KiraFlux/Botix/docs/README.md

# Documentation

Technical documentation for the Botix robot project: assembly guide, part lists, 3D printing settings, electrical schematics, and visual assets.

## Directory Structure

| Path | Description |
| --- | --- |
| `assets/` | Images, renders, and photographs used in the documentation. |
| [`gallery.md`](gallery.md) | Visual gallery of robot iterations and hardware revisions. |
| [`printable_parts.md`](printable_parts.md) | List of printable parts |
| [`firmware_contributing.md`](firmware_contributing.md) | Detailed guidelines for firmware developers (code style, architecture, V‑codes). |
| [`assembly_guide.md`](assembly_guide.md) | Step‑by‑step assembly instructions with photos and diagrams.  *(not implemented yet)* |
| (future) | Electrical schematics, Bill of Materials (BOM), print profiles, and other technical references. |

## Usage

1. Start with [`assembly_guide.md`](assembly_guide.md) to build the robot.
2. Refer to `assets/` for visual references and illustrations.
3. Additional documentation (e.g., BOM, wiring diagrams) will be added here as the project evolves.

## Contributing

If you want to improve the documentation, please read the [general contributing guidelines](../CONTRIBUTING.md) and the [Documentation section](../CONTRIBUTING.md#documentation-docs) for specific rules.

## License

This README file and all other documentation in the `docs/` directory are licensed under **Creative Commons Attribution‑ShareAlike 4.0 International (CC BY‑SA 4.0)** – see the [full license text](LICENSE) for details.

For the complete licensing information of all project components, including hardware and firmware, refer to the [root repository README](../README.md#repository-structure--licensing).
