KiraFlux/Botix/docs/gallery.md

# Botix project gallery

This gallery provides a curated visual overview of the Botix mobile robot project. It collects systematic photographs from the development process (originally published in the project's Telegram channel) and organizes them for quick reference. The images document the evolution of the robot, covering various hardware iterations, chassis assemblies, power electronics, sensor configurations, and controller boards. The gallery will be updated as new revisions and components are introduced.

---

## botix_esp32_2026_07

<table cellspacing="0" cellpadding="0" style="border-collapse: collapse;">
<tr nowrap>
  <td style="padding: 0;"></td>
  <td style="padding: 0;"></td>
  <td style="padding: 0;"></td>
  <td style="padding: 0;"></td>
</tr>
<tr nowrap>
  <td style="padding: 0;"></td>
  <td style="padding: 0;"></td>
  <td style="padding: 0;"></td>
  <td style="padding: 0;"></td>
</tr>
<tr nowrap>
</tr>
  <td style="padding: 0;"></td>
  <td style="padding: 0;"></td>
</table>

ESP32 version on updated chassis. Uses the double‑sided power board (toner transfer method), which was tested on this robot.

---

## botix_uno_2026_07

<table cellspacing="0" cellpadding="0" style="border-collapse: collapse;">
<tr nowrap>
  <td style="padding: 0;"></td>
  <td style="padding: 0;"></td>
  <td style="padding: 0;"></td>
  <td style="padding: 0;"></td>
</tr>
<tr nowrap>
  <td style="padding: 0;"></td>
  <td style="padding: 0;"></td>
  <td style="padding: 0;"></td>
  <td style="padding: 0;"></td>
</tr>
</table>

Current basic-robot version. Chassis with low frames and side walls. Color scheme changed to light colors: white platform and deck, orange walls, frames and sensor mounts. Hardware composition remains the same.

---

## botix_power_v2_ttm_double_2026_07

<table cellspacing="0" cellpadding="0" style="border-collapse: collapse;">
<tr nowrap>
  <td style="padding: 0;"></td>
  <td style="padding: 0;"></td>
  <td style="padding: 0;"></td>
</tr>
<tr nowrap>
  <td style="padding: 0;"></td>
  <td style="padding: 0;"></td>
  <td style="padding: 0;"></td>
  <td style="padding: 0;"></td>
  <td style="padding: 0;"></td>
  <td style="padding: 0;"></td>
</tr>
<tr nowrap>
  <td style="padding: 0;"></td>
  <td style="padding: 0;"></td>
  <td style="padding: 0;"></td>
  <td style="padding: 0;"></td>
  <td style="padding: 0;"></td>
  <td style="padding: 0;"></td>
</tr>
</table>

Double‑layer power board, manufactured using the toner transfer method (TTM).

---

## botix_power_v2_ttm_single_2026_07

<table cellspacing="0" cellpadding="0" style="border-collapse: collapse;">
<tr nowrap>
  <td style="padding: 0;"></td>
  <td style="padding: 0;"></td>
  <td style="padding: 0;"></td>

  <td style="padding: 0;"></td>
</tr>
<tr nowrap>
  <td style="padding: 0;"></td>
  <td style="padding: 0;"></td>
  <td style="padding: 0;"></td>
  <td style="padding: 0;"></td>
</tr>
</table>

Single‑sided version of the same board, also made with toner transfer.

---

## botix_power_v2_pcb_order_2026_07

<table cellspacing="0" cellpadding="0" style="border-collapse: collapse;">
<tr nowrap>
  <td style="padding: 0;"></td>
  <td style="padding: 0;"></td>
  <td style="padding: 0;"></td>
  <td style="padding: 0;"></td>
</tr>
<tr nowrap>
  <td style="padding: 0;"></td>
  <td style="padding: 0;"></td>
  <td style="padding: 0;"></td>
  <td style="padding: 0;"></td>
</tr>
</table>

## botix_power_v2_pcb_order_2026_07

New revision of the power board. After a year of use, limitations of the first version became apparent: lack of terminals, and problems with back‑EMF from servos (a large servo would "kill" a smaller one with its inductance).
Solutions: two independent channels on Mini560 PRO (5V) with 35V 470 µF capacitors on each line; terminals for direct battery voltage output (used to power motor drivers); parallel input before the switch (allows connecting an external source instead of the 3S pack); six mounting holes (3 left, 3 right); outputs now available both via terminals and Dupont headers (for servo connections).

> The version shown in the photos had a routing error - a missing trace between the two holder pads, so a red jumper wire was added on the back side. This has been fixed in the current revision available in the repository.

---

## botix_esp32_2026_05

<table cellspacing="0" cellpadding="0" style="border-collapse: collapse;">
<tr nowrap>
  <td style="padding: 0;"></td>
  <td style="padding: 0;"></td>
</tr>
</table>

Alternative chassis design with low walls and frames — the robot became lower. No rear wall. Power board mounted flat on the platform. This is an ESP32 robot with a manipulator.

---

## botix_esp32_2026_03

<table cellspacing="0" cellpadding="0" style="border-collapse: collapse;">
<tr nowrap>
  <td style="padding: 0;"></td>
  <td style="padding: 0;"></td>
</tr>
</table>

Second iteration of the ESP32 robot. Uses the same module with a shield (ESP32D DevKit), but instead of a motor shield, separate DRV8871 motor drivers are used.

---

## botix_uno_2025_09

<table cellspacing="0" cellpadding="0" style="border-collapse: collapse;">
<tr nowrap>
  <td style="padding: 0;"></td>
  <td style="padding: 0;"></td>
  <td style="padding: 0;"></td>
</tr>
<tr nowrap>
</tr>
  <td style="padding: 0;"></td>
  <td style="padding: 0;"></td>
  <td style="padding: 0;"></td>
</table>

<table cellspacing="0" cellpadding="0" style="border-collapse: collapse;">
<tr nowrap>
  <td style="padding: 0;"></td>
  <td style="padding: 0;"></td>
</tr>
</table>

A direct evolution of the MOSH version with improved chassis and simplified assembly. Once the chassis was finalized and power boards manufactured, the school robotics team needed robots. Three units with manipulators were made. Manipulator changes: the 1109 servo was replaced by a more common MG90S, and the gear was modified. Module set: Arduino UNO + IArduino motor shield, IArduino module for line sensor, SHARP for distance sensing.

---

## botix_power_v1_2025_09

<table cellspacing="0" cellpadding="0" style="border-collapse: collapse;">
<tr nowrap>
  <td style="padding: 0;"></td>
  <td style="padding: 0;"></td>
  <td style="padding: 0;"></td>
</tr>
<tr nowrap>
  <td style="padding: 0;"></td>
  <td style="padding: 0;"></td>
</tr>
</table>

First version of the power board. Replaced the 18650 cells used in early prototypes with 14500 — more compact and safer for school use. Goal: simplify assembly and eliminate point‑to‑point wiring. Features: holder for 3S 14500 with direct access for quick replacement; switch breaking the negative line; two alternative footprints: either 2PH116602A or (on the reverse side) Mini560 PRO (5V) for isolated servo power; LM2596S with digital voltmeter for voltage monitoring (output set to 8V for the motor shield). This ensured stable motor speed as the battery discharged.

---

## botix_esp32_2025_08

<table cellspacing="0" cellpadding="0" style="border-collapse: collapse;">
<tr nowrap>
  <td style="padding: 0;"></td>
  <td style="padding: 0;"></td>
  <td style="padding: 0;"></td>
</tr>
</table>

Based on experience from VSOSH and MOSH, a new chassis was designed to be logical and not require future rework. Key decisions: strict 20 mm grid; unified tongue‑and‑groove pattern (also grid‑aligned); frames compatible with the manipulator from the TsPM (VSOSH). Uses: ball casters (as on the VSOSH robot), off‑the‑shelf RC wheels (D52 rim, 67 mm tyre). The rear wall does not contain a holder or converter — a full power board is installed (first iteration made with toner transfer, later production ordered). First attempt to use ESP32 as the main controller. Motor driver: IArduino UNO Motor Shield. Manipulator from TsPM: MG995 for the arm, 1109 for the gripper. Uses analogue sensors from Amperka (with potentiometer sensitivity adjustment) — same as used at VSOSH 2024/2025.

---

## historic_mosh_2024_11

<table cellspacing="0" cellpadding="0" style="border-collapse: collapse;">
<tr nowrap>
  <td style="padding: 0;"></td>
  <td style="padding: 0;"></td>
  <td style="padding: 0;"></td>
</tr>
<tr nowrap>
  <td style="padding: 0;"></td>
  <td style="padding: 0;"></td>
  <td style="padding: 0;"></td>
</tr>
</table>

Stage where successful features from the VSOSH chassis were adopted: open removable power board as a whole wall, deck above the motors for the controller. Introduced a 10‑mm grid with a successful slot pattern. Adapters were developed to mount VSOSH frames on the MOSH platform, allowing the manipulator to be used.

---

## historic_vsosh_2024_08

<table cellspacing="0" cellpadding="0" style="border-collapse: collapse;">
<tr nowrap>
  <td style="padding: 0;"></td>
  <td style="padding: 0;"></td>
  <td style="padding: 0;"></td>
</tr>
<tr nowrap>
  <td style="padding: 0;"></td>
  <td style="padding: 0;"></td>
  <td style="padding: 0;"></td>
</tr>
</table>

Chassis inspired by the robot shown by TsPM at the Moscow practical round. Originally designed for laser cutting from 4‑mm plywood, but 3D printing proved simpler and neater. Uses printed wheels and a plumbing‑grade rubber tyre (74 mm diameter) to simulate the slipping behavior of the original olympiad robot. Frames are compatible with the TsPM manipulator, but a first iteration of a custom manipulator with two MG90S servos was developed. Drawbacks: using MG90S for the arm linkage proved unsuccessful; gripper teeth too aggressive; scale about 1.5× larger than the olympiad robot.

---

## historic_mosh_2024_06

<table cellspacing="0" cellpadding="0" style="border-collapse: collapse;">
<tr nowrap>
  <td style="padding: 0;"></td>
  <td style="padding: 0;"></td>
  <td style="padding: 0;"></td>
</tr>
</table>

Switch to 3S (12V) power. Power module moved to the rear and made as a closed box with point‑to‑point wiring. Updated Arduino UNO adapter (added rear slots). Attempt to expand workspace with wheel covers. First experience with 3D‑printed wheel rims.

---

## historic_mosh_2024_01

<table cellspacing="0" cellpadding="0" style="border-collapse: collapse;">
<tr nowrap>
  <td style="padding: 0;"></td>
  <td style="padding: 0;"></td>
</tr>
<tr nowrap>
  <td style="padding: 0;"></td>
  <td style="padding: 0;"></td>
</tr>
</table>

Platform updated: more holes and bottom reinforcement ribs added.

---

## historic_mosh_2023_03

<table cellspacing="0" cellpadding="0" style="border-collapse: collapse;">
<tr nowrap>
  <td style="padding: 0;"></td>
  <td style="padding: 0;"></td>
  <td style="padding: 0;"></td>
</tr>
</table>

Earliest documented iteration. Powered by 2S 18650, stabilized with LM2596S and voltmeter. Arduino UNO mounted via an adapter to neutralize its irregular hole pattern. Used ball casters (inherited from the Amperka MiniQ). Round shape inspired by the MiniQ to simplify pivot turns.
