KiraFlux/Botix/docs/printable_parts.md

# Printable parts

## Chassis

<table cellspacing="0" cellpadding="0" style="border-collapse: collapse;">

<tr nowrap>
<td style="padding: 0;"></td>
<td style="padding: 0;"></td>
<td style="padding: 0;"></td>
<td style="padding: 0;"></td>
<td style="padding: 0;"></td>
<td style="padding: 0;"></td>
<td style="padding: 0;"></td>
</tr>

<tr nowrap>

<td align="center">
  
[platform](../mcad/export/platform.stp)

</td>

<td align="center">
  
[deck](../mcad/export/deck.stp)

</td>

<td align="center">
  
[nose_deck](../mcad/export/nose_deck.stp)

</td>

<td align="center">
  
[frame_small](../mcad/export/frame_small.stp)

</td>

<td align="center">
  
[side_wall_small](../mcad/export/side_wall_small.stp)

</td>

<td align="center">

[rear_wall](../mcad/export/rear_wall.stp)  

</td>

<td align="center">

[felt_support](../mcad/export/felt_support.stp)  

</td>

</tr>

</table>

## Mounts

<table cellspacing="0" cellpadding="0" style="border-collapse: collapse;">

<tr nowrap>
<td style="padding: 0;"></td>
<td style="padding: 0;"></td>
<td style="padding: 0;"></td>
</tr>

<tr nowrap>

<td align="center">
  
[sharp_mount](../mcad/export/sharp_mount.stp)

</td>

<td align="center">
  
[sharp_cover](../mcad/export/sharp_cover.stp)

</td>

<td align="center">
  
[hscr04_mount](../mcad/export/hscr04_mount.stp)

</td>

</tr>

</table>

## Fasteners

<table cellspacing="0" cellpadding="0" style="border-collapse: collapse;">

<tr nowrap>
<td style="padding: 0;"></td>
<td style="padding: 0;"></td>
</tr>

<tr nowrap>

<td align="center">
  
[bushing_m3](../mcad/export/bushing_m3.stp)

</td>

<td align="center">
  
[short_bushing_m3](../mcad/export/short_bushing_m3.stp)

</td>

</tr>

</table>
