KiraFlux/Botix/(list of files, cad)

Other CAD files:
mcad/botix.fcstd
mcad/export/felt_support.stp
mcad/import/chassis/side_wall_small.stp
mcad/import/manipulator/lever_left.stp
mcad/models/devboards/arduino_uno_rev3.stp
mcad/models/misc/protoboard_170.stp
mcad/models/motors/mg995_servo.stp
mcad/models/power/botix_power_module_14500_3s_v1.stp
mcad/models/sensors/lidar_ld06.stp
mcad/export/platform.stp
mcad/import/chassis/platform.stp
mcad/import/manipulator/lever_right.stp
mcad/models/misc/rc_car_wheel_d52.stp
mcad/models/motors/mg90s_servo.stp
mcad/models/sensors/sharp_gp2y0a41sk0f.stp
mcad/export/short_bushing_m3.stp
mcad/import/chassis/bracket.stp
mcad/import/manipulator/wall.stp
mcad/models/misc/coupling_m4.stp
mcad/models/motors/ga25_motor.stp
mcad/models/sensors/hcsr04_ultrasonic.stp
mcad/export/nose_deck.stp
mcad/import/chassis/arc_support.stp
mcad/import/manipulator/link_v1.stp
mcad/models/sensors/TCRT5000_reflective.stp
mcad/export/deck.stp
mcad/import/chassis/deck.stp
mcad/import/manipulator/cover.stp
mcad/models/sensors/vl53l1x_tof.stp
mcad/export/frame_small.stp
mcad/import/chassis/frame.stp
mcad/import/manipulator/drive_gear.stp
mcad/export/rear_wall.stp
mcad/import/chassis/side_wall.stp
mcad/export/bushing_m3.stp
mcad/import/chassis/rear_wall.stp
mcad/export/side_wall_small.stp
mcad/import/chassis/felt_support.stp
mcad/export/hscr04_mount.stp
mcad/export/sharp_cover.stp
mcad/export/sharp_mount.stp
mcad/models/sensors/icm20948v2_imu.stp
mcad/models/sensors/lidar_ld06.fcstd
