KiraFlux/Botix/(threads)

Thread 11 (2025-05-27):

Новый Mount GA25

JamahaW, 2025-05-27:
3D-печатное крепление для установки GA25 на платформу.
Унифицированное крепление

Closed 2025-07-19.

Thread 16 (2025-06-01):

Изменить структуру хранения версий модулей

JamahaW, 2025-06-01:
Модули, которые существуют в нескольких версиях, должны быть совместимы с предыдущими версиями. Для этого в модуле должен быть доступен файл модели профиля, который обеспечит совместимость. Чтобы обеспечить однозначность и простоту иерархии, структуру модуля необходимо изменить следующим образом:

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

Closed 2025-06-05.
