KiraFlux/Botix/(commit log)

2026-07-07 Initial commit: clean start after migration to FreeCAD
    [TCRT5000_reflective.stp, arc_support.stp, arduino_uno_rev3.stp, botix.fcstd, botix_power_module_14500_3s_v1.stp, bracket.stp, coupling_m4.stp, cover.stp]
2026-07-07 refactor: rename print_profiles -> orca_slicer_profiles
2026-07-08 feat: add "Printable" property to 3d-printable mechanical parts
    [botix.fcstd]
2026-07-08 fix(printable export): use explicit 'is not None' with lambda
2026-07-08 refactor(export-script): use STL mesh export cuz OrcaSlicer CLI issues
2026-07-08 revert last refactor: roll back to solid STP export due to broken OrcaSlicer pipeline
    OrcaSlicer CLI/GUI implementation is a pure developer skill issue:
    1. Headless CLI execution is fundamentally broken. Attempting to use the `--load-assemble-list` flag triggers an unhandled segmentation fault (SIGSEGV) deep within the PrusaSlicer/Bambu legacu-core, because the `Arrange` and `ModelObject` functions are hard-tied to the uninitialized GUI object tree.
    2. The `assemble_list.json` schema is entirely undocumented and hidden. The graphical user interface (GUI) provides absolutely no menu buttons, CLI hooks, or file filters to import this config manually in normal mode.
    3. Passing custom JSON confi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
2026-09-01 repo restructuring: monorepo
    - Converted to monorepo with clear separation: ecad hardware, mcad mechanics, botix-esp32 firmware, docs documentation, tools scripts
    - Root README.md and README.ru.md rewritten
    - Added CONTRIBUTING.md and docs/firmware_contributing.md
    Added docs/gallery.md with historical photos
    - Added docs/assembly_guide.md
    - Updated licenses: docs under CC BY-SA, ecad and mcad under CERN-OHL-S, botix-esp32 and tools under GPL
    - Fixed .gitignore
    - Integrated firmware from external repo into botix-esp32
    - Migrated scripts into tools
    [BackupProjects_maxnaw99_personal_0_20260709.kicad_pcb, BackupProjects_maxnaw99_personal_0_20260709.kicad_sch, TCRT5000_reflective.stp, arc_support.stp, arduino_uno_rev3.stp, botix.fcstd, botix_power_module_14500_3s_v1.stp, botix_power_module_v2.kicad_pcb]
2026-09-16 feat: add printable parts list, store export step models
    [bushing_m3.stp, deck.stp, felt_support.stp, frame_small.stp, hscr04_mount.stp, nose_deck.stp, platform.stp, rear_wall.stp]
2026-10-02 Merge pull request #45 from KiraFlux/botix-esp32
    improve firmware: fix telemetry timestamp, lidar, queue for mavlink messages
